josephcabrera-cmyk/birthday-countdown-clock/docs/source/presentation.pptx

## Birthday Countdown Timer

By Joseph Cabrera

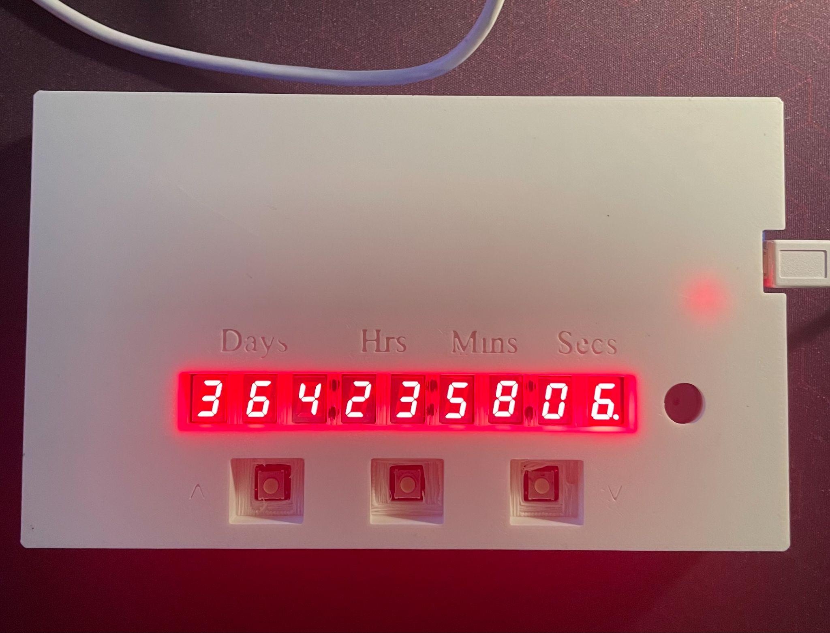
[picture p4: figure]

## Schematic Diagram Pt. 1

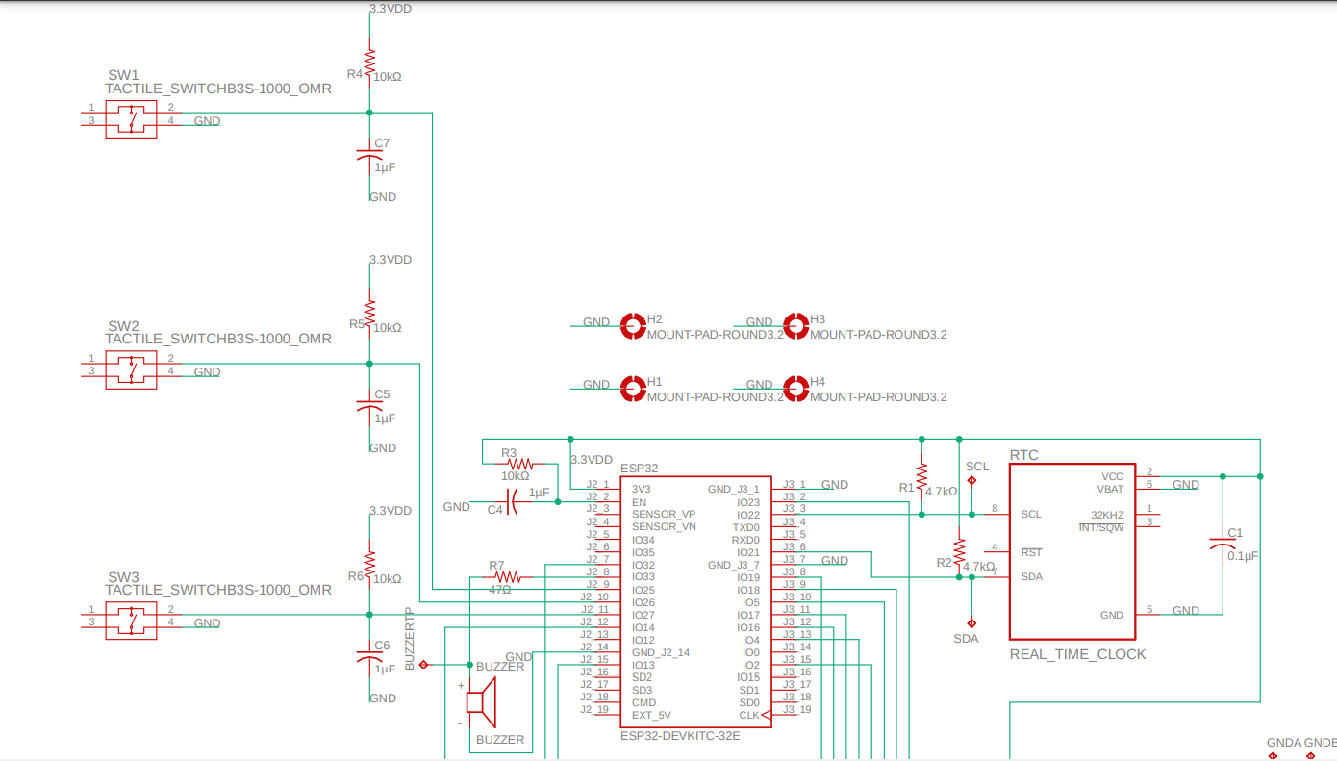
[picture p5: figure]

- ESP32-Devkit

- 3 Pushbuttons

- Buzzer

- Real-Time Clock

- Grounded Mounting Holes

## Schematic Diagram Pt.2

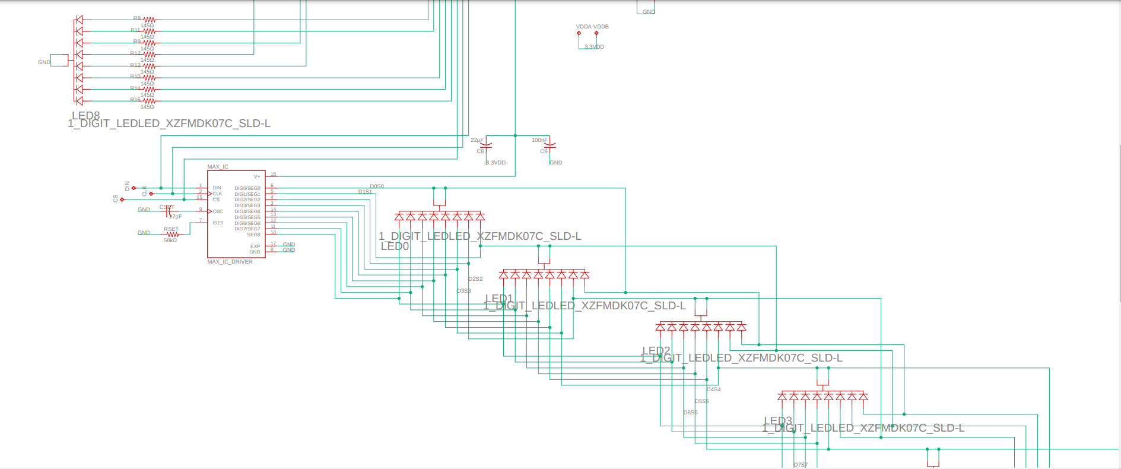
[picture p6: figure]

…

- 7-segment LED connected directly to ESP32-Devkit

- Eight 7-segment LEDs driven by display driver

- Display Driver

## Board Layout

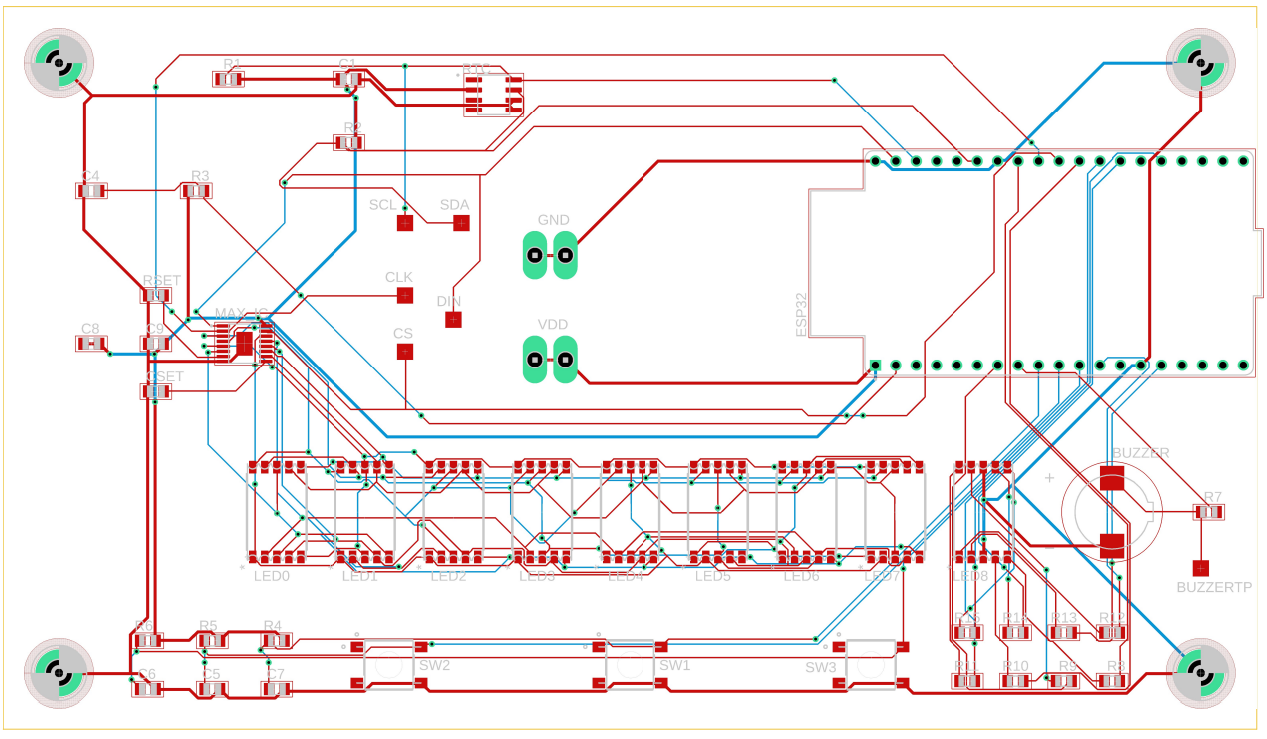
[picture p7: figure]

- ESP32-Devkit

- Real-Time Clock

- Display Driver

- Nine 7-segment LEDs

- Three Pushbuttons

- Buzzer

- Test Points

## Board Photos


## Case Design (Bottom)

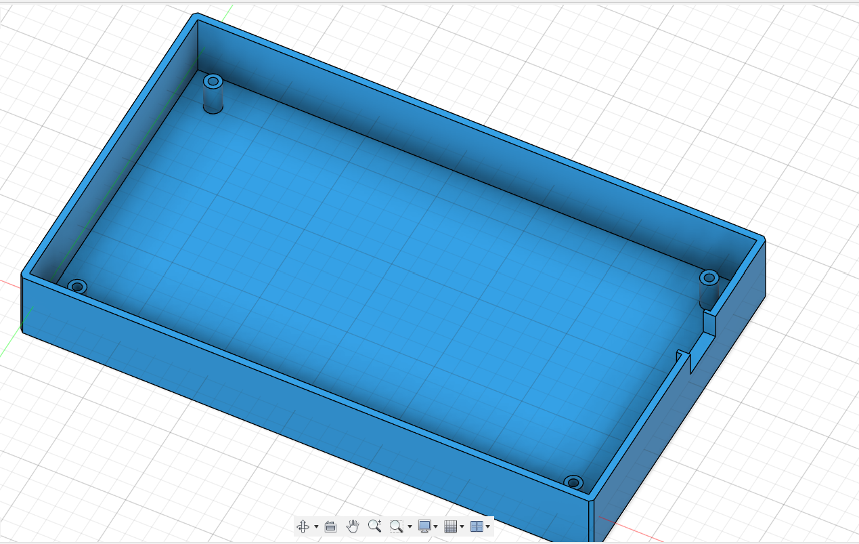
[picture p8: figure]

- Four screw holes diameter of 2.6mm

- Micro USB insert hole

## Case Design (Top)

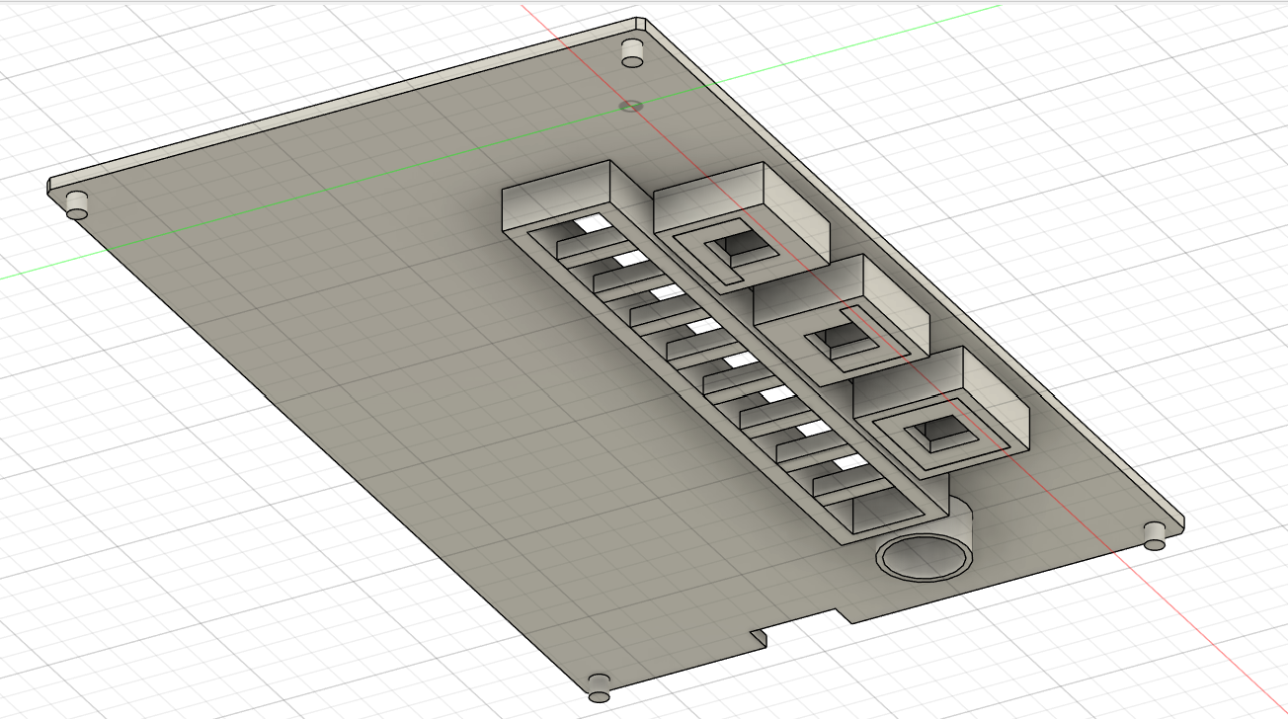
[picture p9: figure]

- Four tangential pins for connecting to the bottom

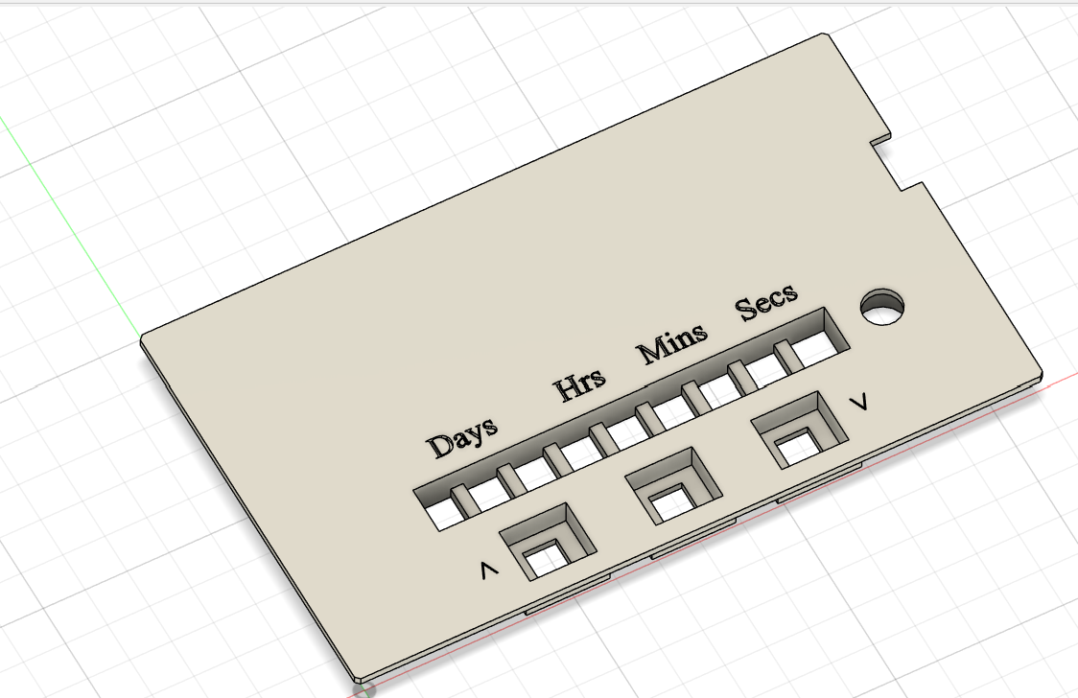
[picture p10: figure]

- Holes for 7-segment LEDs

- Holes for pushbuttons

- Hole for the buzzer

- Some text

- Indent for micro USB

## Results

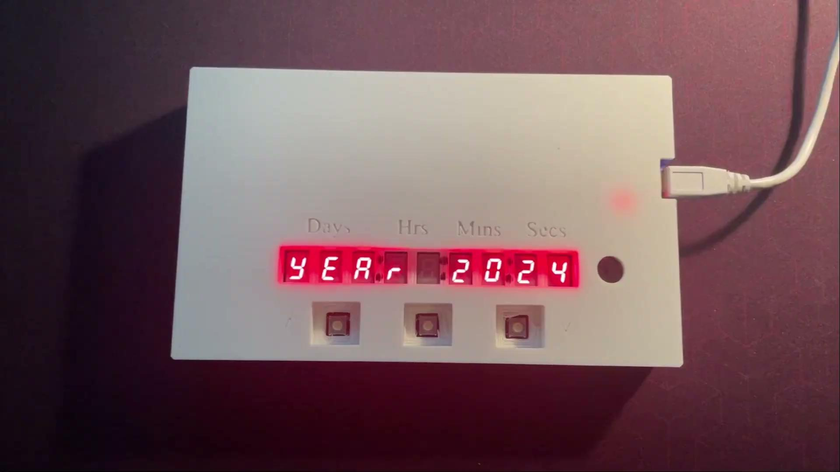
[picture p11: figure]
