josephcabrera-cmyk/birthday-countdown-clock/docs/presentation.pdf

# Birthday Countdown Timer

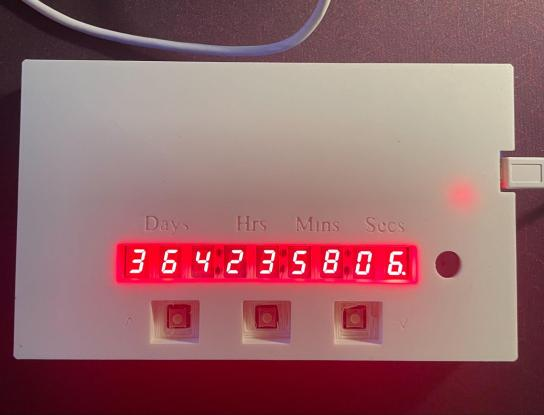
[picture p12: figure]

# By Joseph Cabrera

## Schematic Diagram Pt. 1

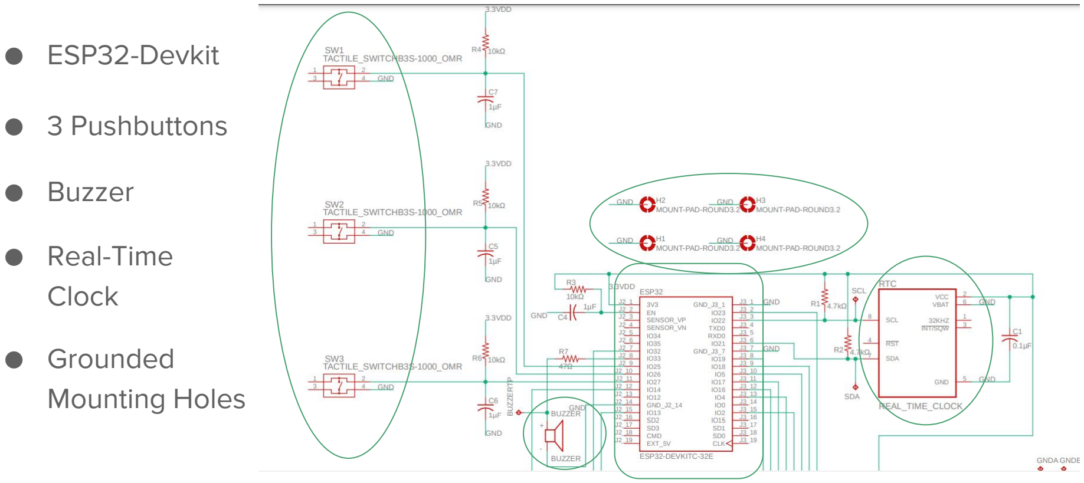
[picture p13: figure]
● ESP32-Devkit; ● 3 Pushbuttons; ● Buzzer; ● Real-Time Clock; ● Grounded Mounting Holes

## Schematic Diagram Pt.2

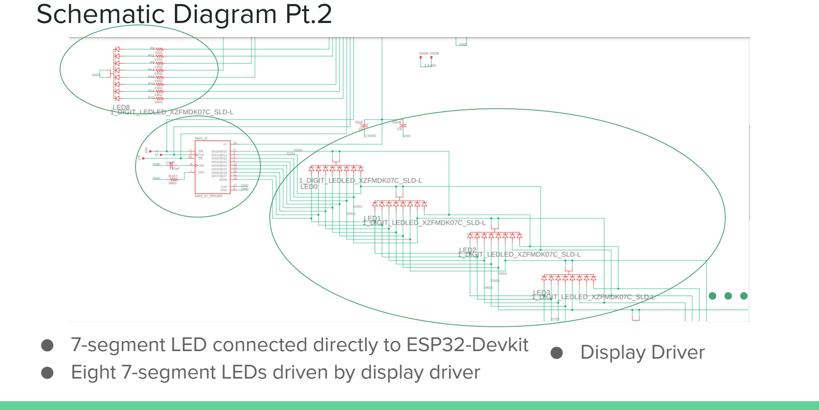
[picture p14: page 3]

- 7-segment LED connected directly to ESP32-Devkit ● Display Driver
- Eight 7-segment LEDs driven by display driver

…

## Board Layout

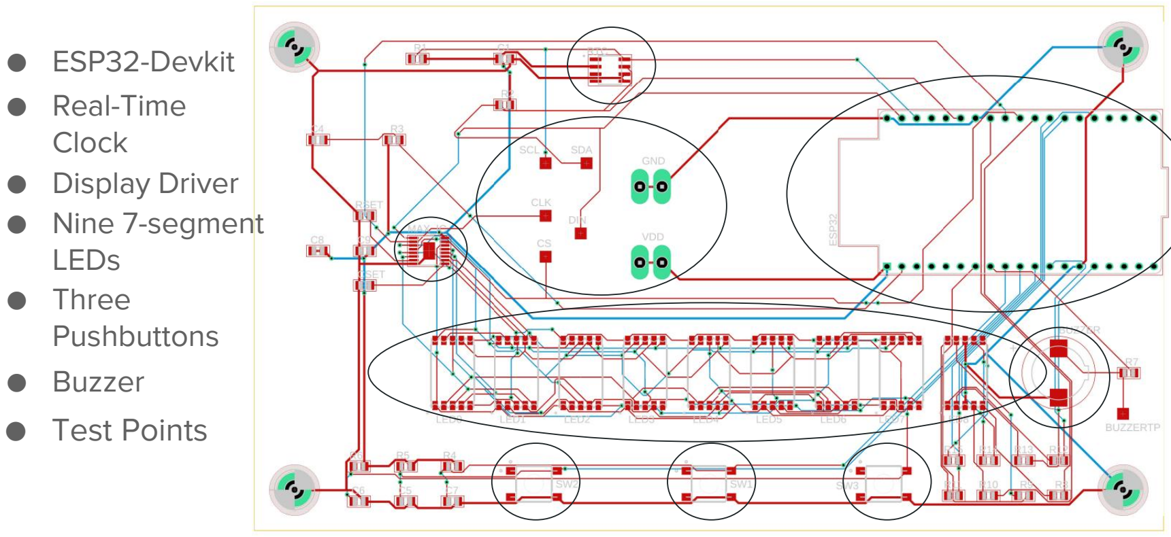
[picture p15: figure]
● ESP32-Devkit ● Real-Time Clock ● Display Driver ● Nine 7-segment LEDs ● Three Pushbuttons ● Buzzer ● Test Points

## Board Photos

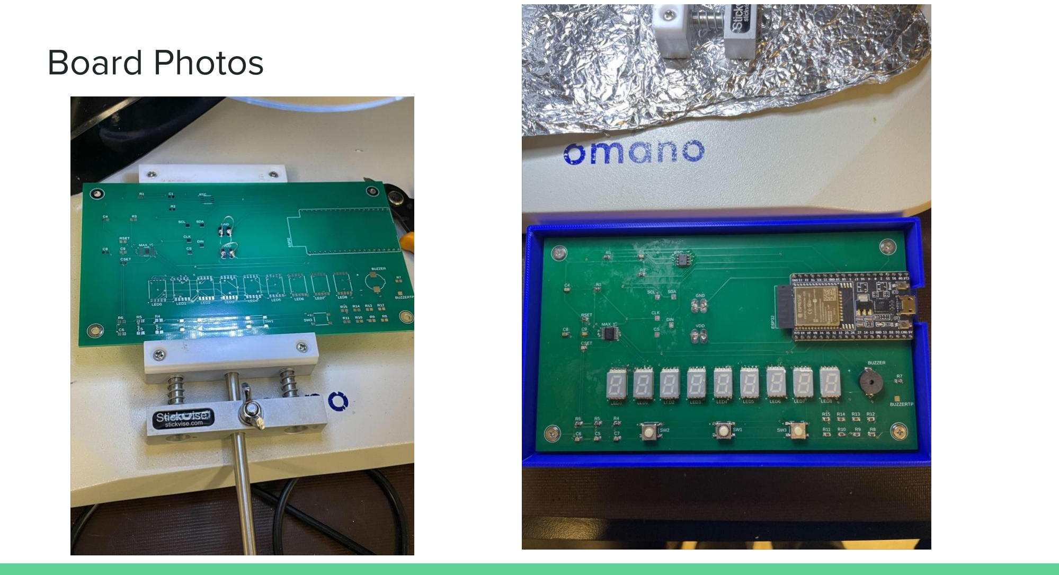
[picture p16: page 5]

## Case Design (Bottom)

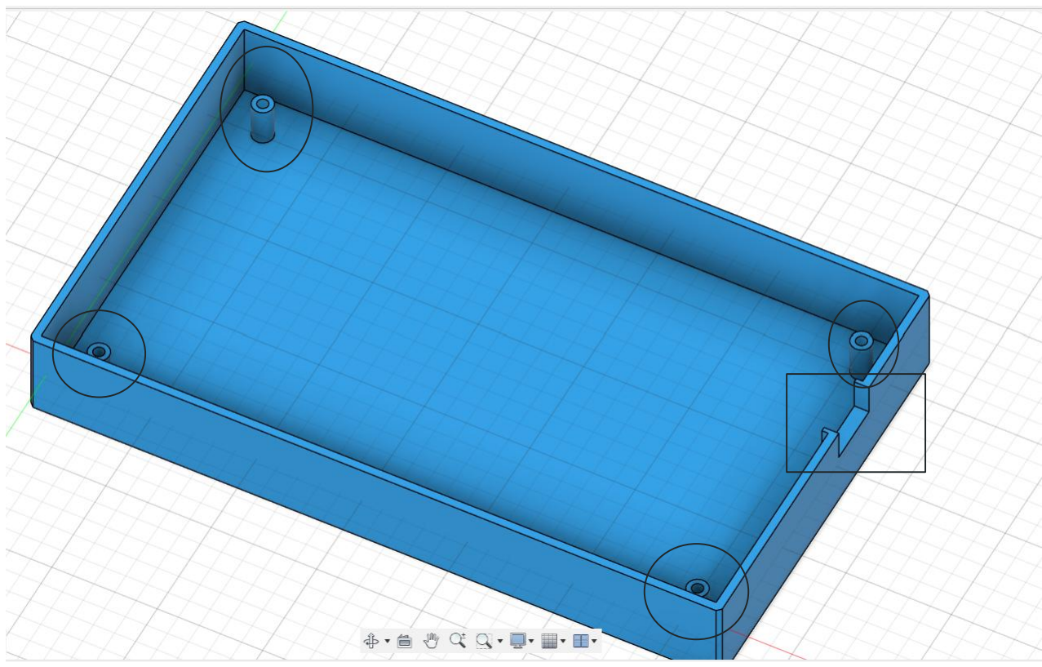
[picture p17: figure]

- Four screw holes
diameter of
2.6mm
- Micro USB
insert hole

## Case Design (Top)

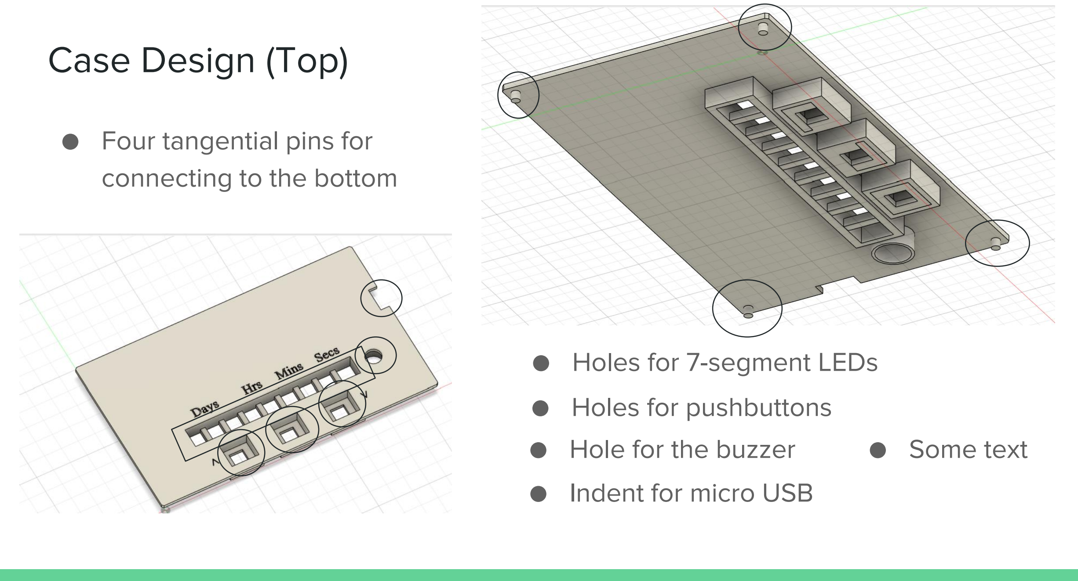
[picture p18: page 7]

- Four tangential pins for connecting to the bottom
- Holes for 7-segment LEDs
- Holes for pushbuttons
- Hole for the buzzer
- Indent for micro USB
- Some text

## Results

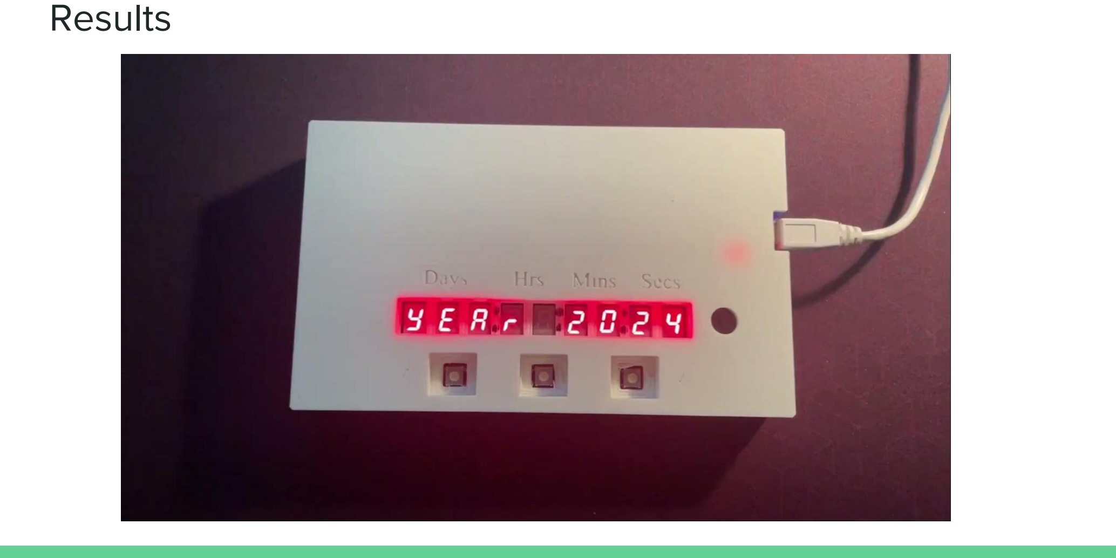
[picture p19: page 8]

Untitled video (1).mp4 (http://drive.google.com/file/d/1gSHd87OxV9lMGyYuL7m6IwtHUoTBj-bI/view)
