josephcabrera-cmyk/birthday-countdown-clock/hardware/board-layout.pdf

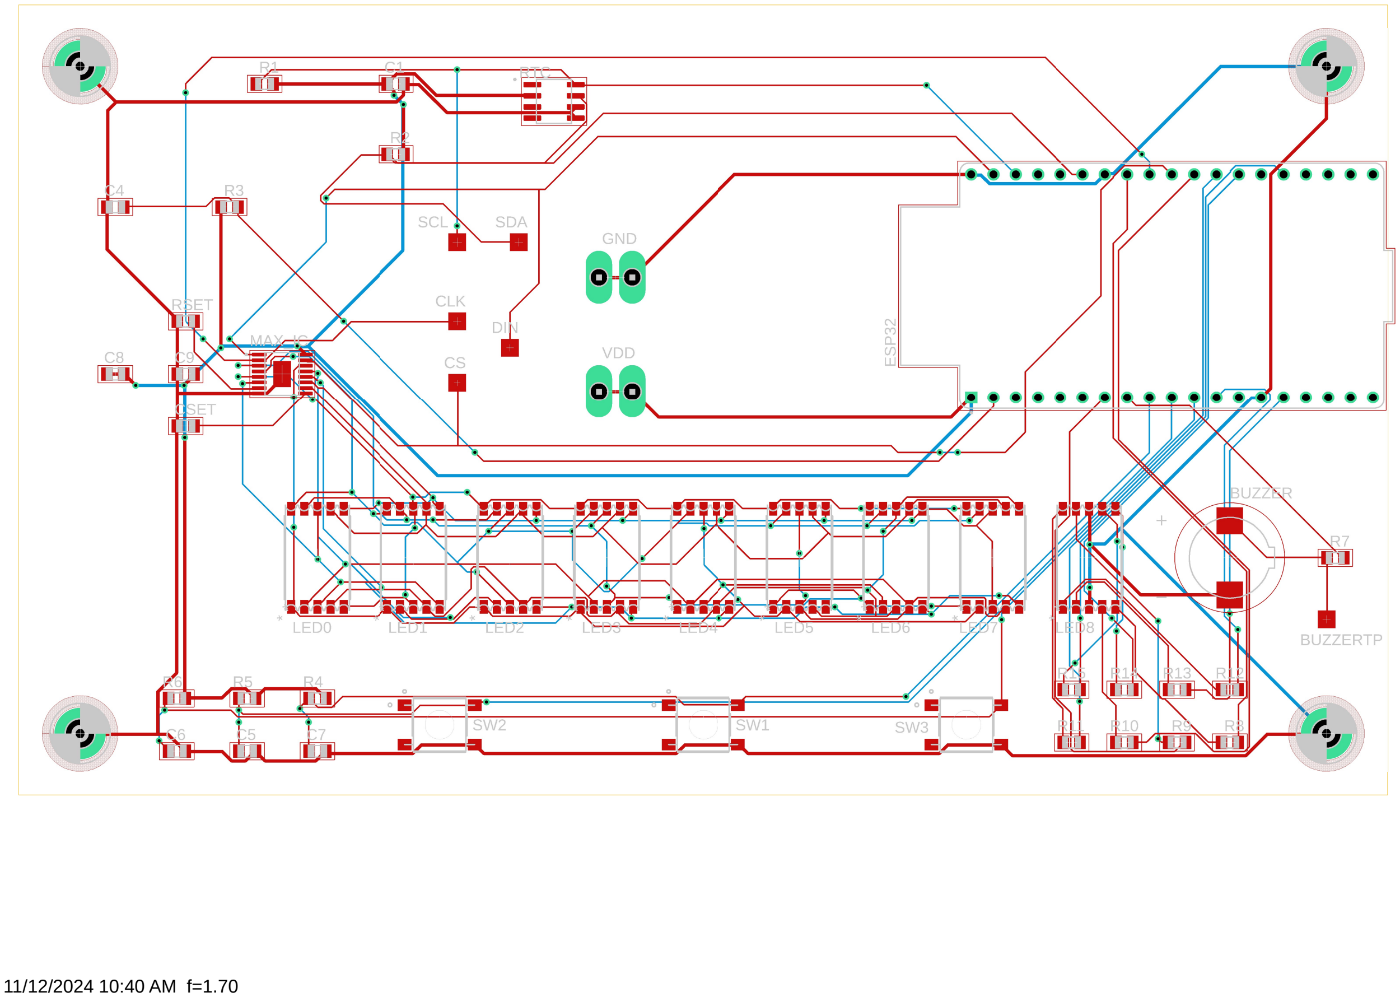
[picture p20: page 1]

11/12/2024 10:40 AM f=1.70
