josephcabrera-cmyk/birthday-countdown-clock/hardware/source/bill-of-materials.xlsx

Reference Designator | Vendor | Vendor part # | Manufacturer | Manufacturer part # | Quantity required
ESP32 | DigiKey | 1965-ESP32-DEVKITC-32E-ND | Espressif Systems | ESP32-DEVKITC-32E | 1
RTC | DigiKey | 175-DS3231MZ+TRLCT-ND | Analog Devices Inc./Maxim Integrated | DS3231MZ+TRL | 1
LED0-8 | DigiKey | 1497-1373-2-ND | SunLED | XZFMDK07C | 9
MAX_IC | DigiKey | MAX6951CEE+-ND | Analog Devices Inc./Maxim Integrated | MAX6951CEE+ | 1
SW1-3 | DigiKey | SW415-ND | Omron Electronics Inc-EMC Div | B3S-1000 | 3
BUZZER | DigiKey | 668-SMTB-0927-TW-RTR-ND | PUI Audio, Inc. | SMTB-0927-TW-R | 1
R1-R2 | DigiKey | 541-4131-2-ND | Vishay Dale | CRCW08054K70FKEAC | 2
R3-R6 | DigiKey | RMCF0805FT10K0TR-ND | Stackpole Electronics Inc | RMCF0805FT10K0 | 4
R7 | DigiKey | RMCF0805JT47R0TR-ND | Stackpole Electronics Inc | RMCF0805JT47R0 | 3
R8-R15 | DigiKey | TNPW0805145RDHEA-ND | Vishay Dale | TNPW0805145RDHEA | 8
RSET | DigiKey | P56KATR-ND | Panasonic Electronic Components | ERJ-6GEYJ563V | 1
C1,C9 | DigiKey | 3372-0805B104K500BDTR-ND | Aillen | 0805B104K500BD | 1
C4-C7 | DigiKey | 3372-0805B105K100CCTR-ND | Aillen | 0805B105K100CC | 4
C8 | DigiKey | 3372-0805W226M100CCTR-ND | NextGen Components | 0805W226M100CC | 1
CSET | DigiKey | 490-5869-2-ND | Murata Electronics | GRM1555C1H270JA01D | 1
- | JLCPCB | - | JLCPCB | - | 1
