josephcabrera-cmyk/birthday-countdown-clock/hardware/board-3d.step

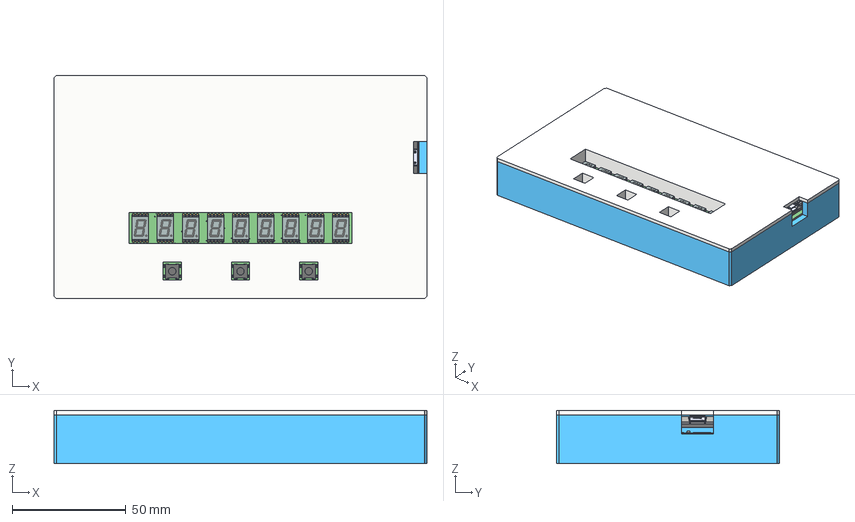
[picture p21: CAD file, 2026-08-03]
hardware/board-3d.step
164.0 x 98.0 x 23.5 mm
Board
1-copper
16-copper
1-soldermask
16-soldermask
C0805 x 8
R0805 x 16
Main-PCB
zl201-19_p2-54_l48-3_w2-54_h8-9 x 2
Soldering-Contacts
ab2_usb_micro_smd.wrl
ESP32-chip
3x4x2mm_tact_button x 2
3,2-PAD (1)
3,2-PAD
3,2-PAD (2)
3,2-PAD (3)
P2-38-20
P2-38-20 (1)
TP20SQ
TP20SQ (1)
TP20SQ (2)
TP20SQ (3)
TP20SQ (4)
TP20SQ (5)
XZFxx07x v1
XZFxx07x v4 (2)
XZFxx07x v4 (3)
XZFxx07x v4 (4)
XZFxx07x v4 (6)
XZFxx07x v4
XZFxx07x v4 (5)
XZFxx07x v4 (1)
LED_XZFMDK07C_SLD-L (1)
B3S-1000_OMR
B3S-1000_OMR (2)
B3S-1000_OMR (1)
SOP63P602X173-17N
SOIC127P600X175-8N
XDCR_SMTB-0927-TW-R
