josephcabrera-cmyk/birthday-countdown-clock/hardware/bill-of-materials.pdf

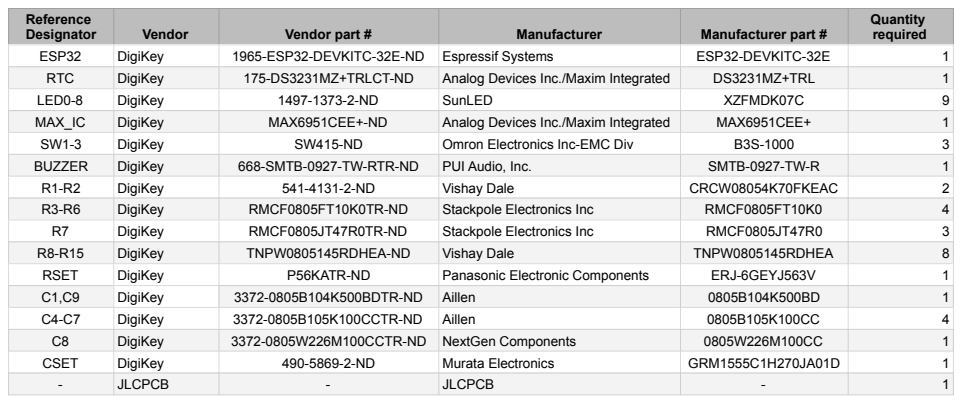
[picture p22: page 1]
Reference; Designator; Vendor; Vendor part #; Manufacturer; Manufacturer part #; Quantity required; ESP32; DigiKey; 1965-ESP32-DEVKITC-32E-ND; Espressif Systems; ESP32-DEVKITC-32E; RTC; 175-DS3231MZ+TRLCT-ND; Analog Devices Inc./Maxim Integrated; DS3231MZ+TRL; LED0-8; SunLED; XZFMDK07C; MAX_IC; MAX6951CEE+-ND; MAX6951CEE+; Omron Electronics Inc-EMC Div; BUZZER; 668-SMTB-0927-TW-RTR-ND; PUI Audio, Inc.; SMTB-0927-TW-R; Vishay Dale; CRCW08054K70FKEAC; RMCF0805FT10K0TR-ND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
