josephcabrera-cmyk/birthday-countdown-clock/hardware/schematic.pdf

# 10kΩ MAX_IC_DRIVER

## TACTILE_SWITCHB3S-1000_OMR

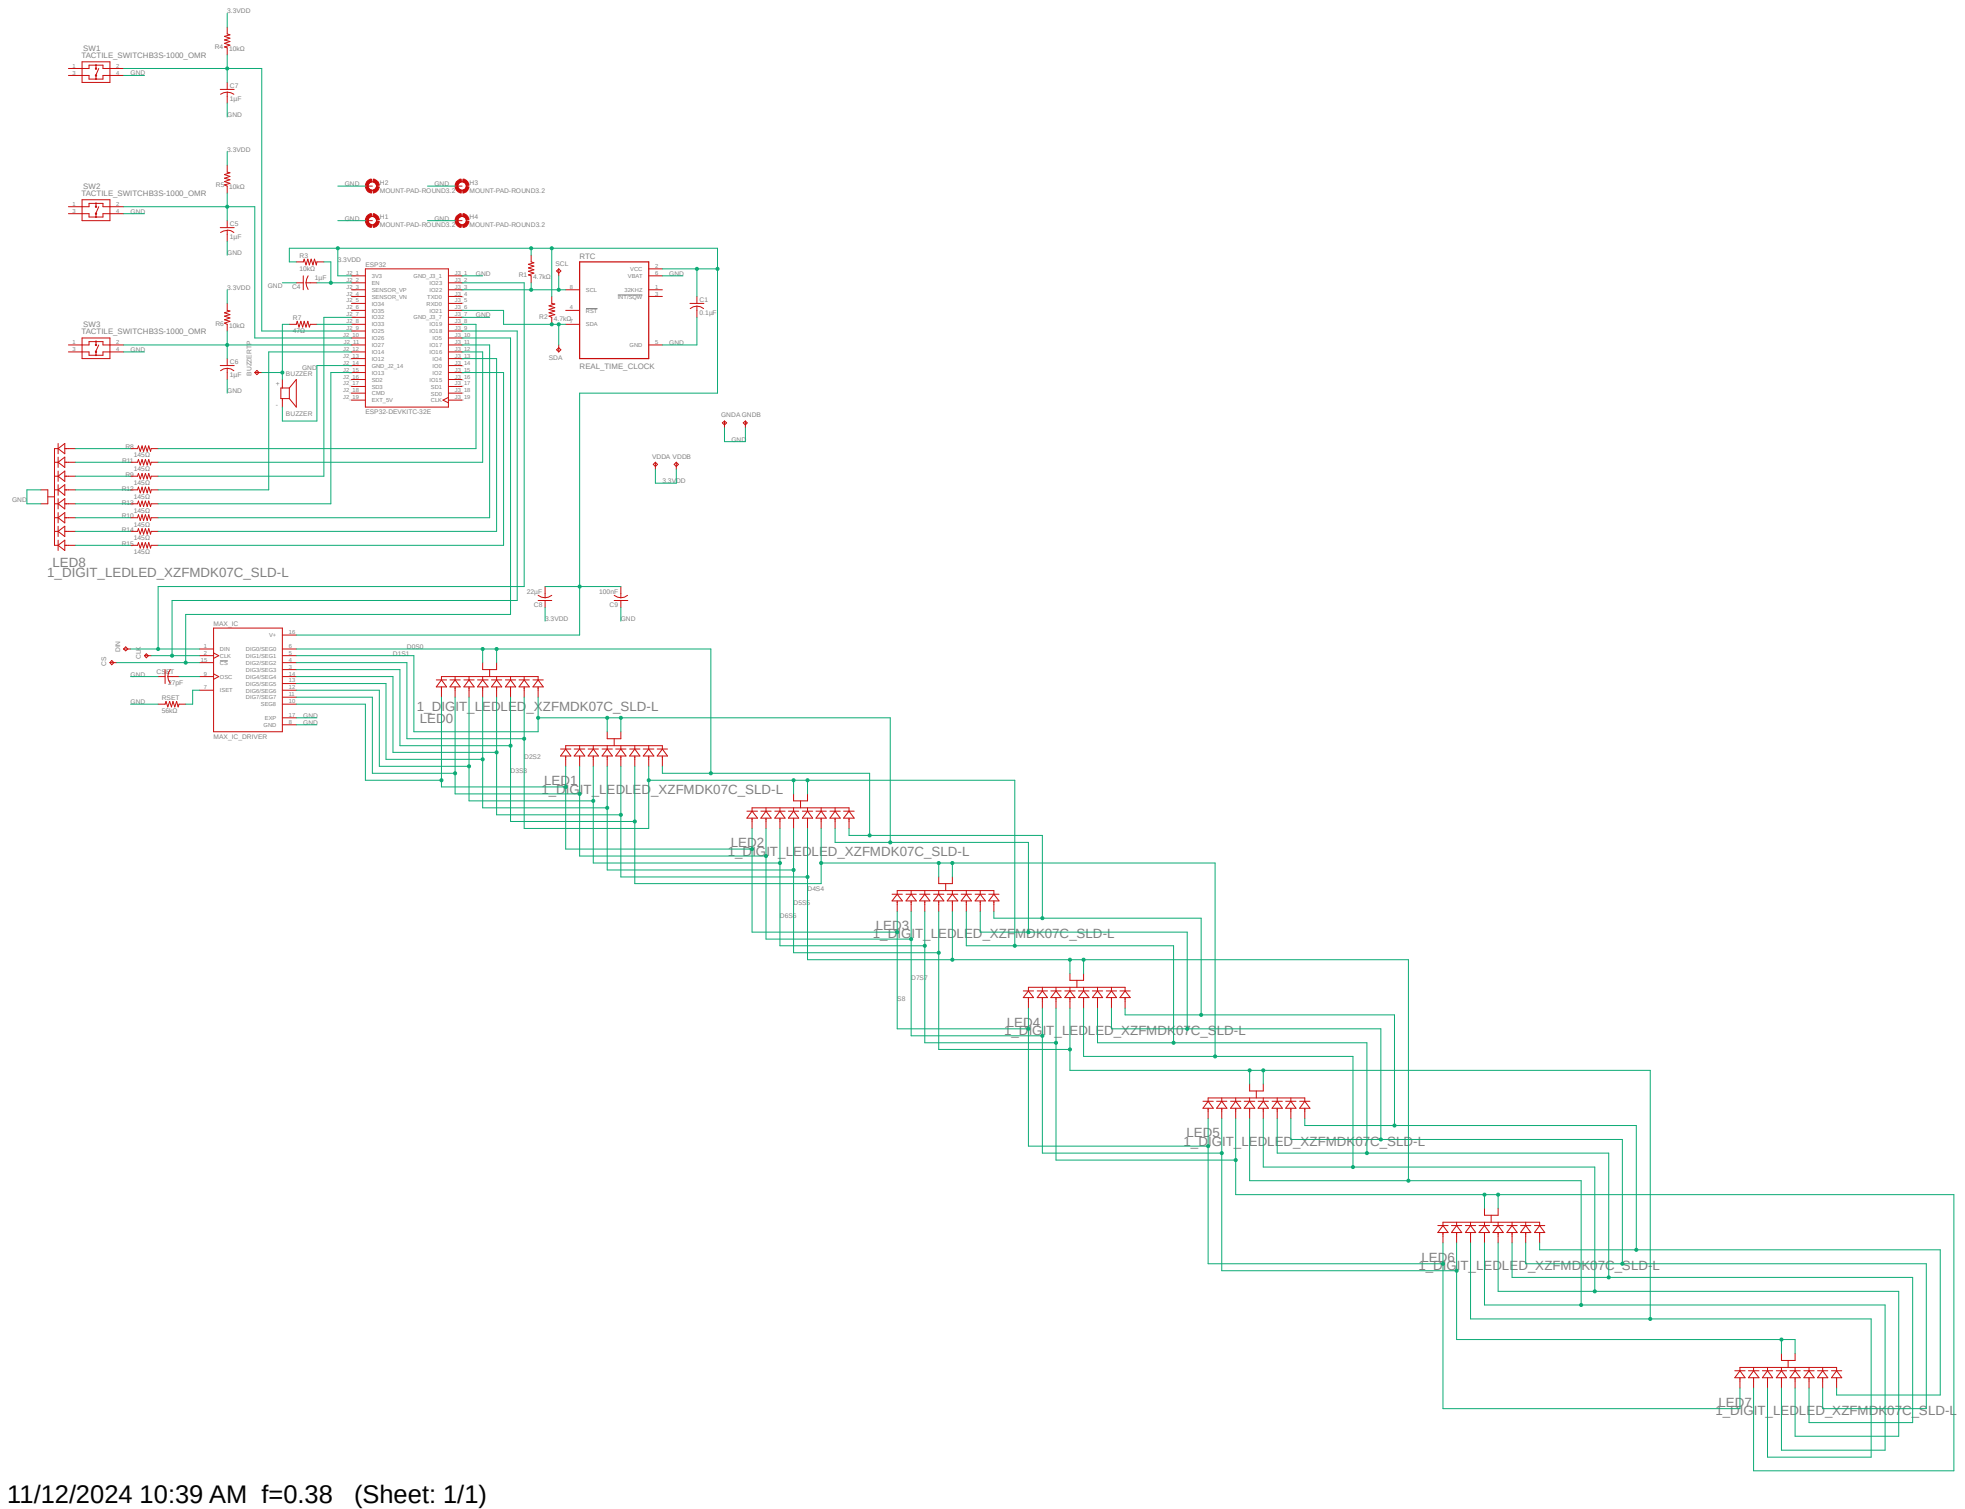
[picture p23: page 1]

VDDA VDDB DIN CS
