josephcabrera-cmyk/birthday-countdown-clock/hardware/source/birthday-countdown-clock.brd

## EAGLE design hardware/source/birthday-countdown-clock.brd (2026-08-03)

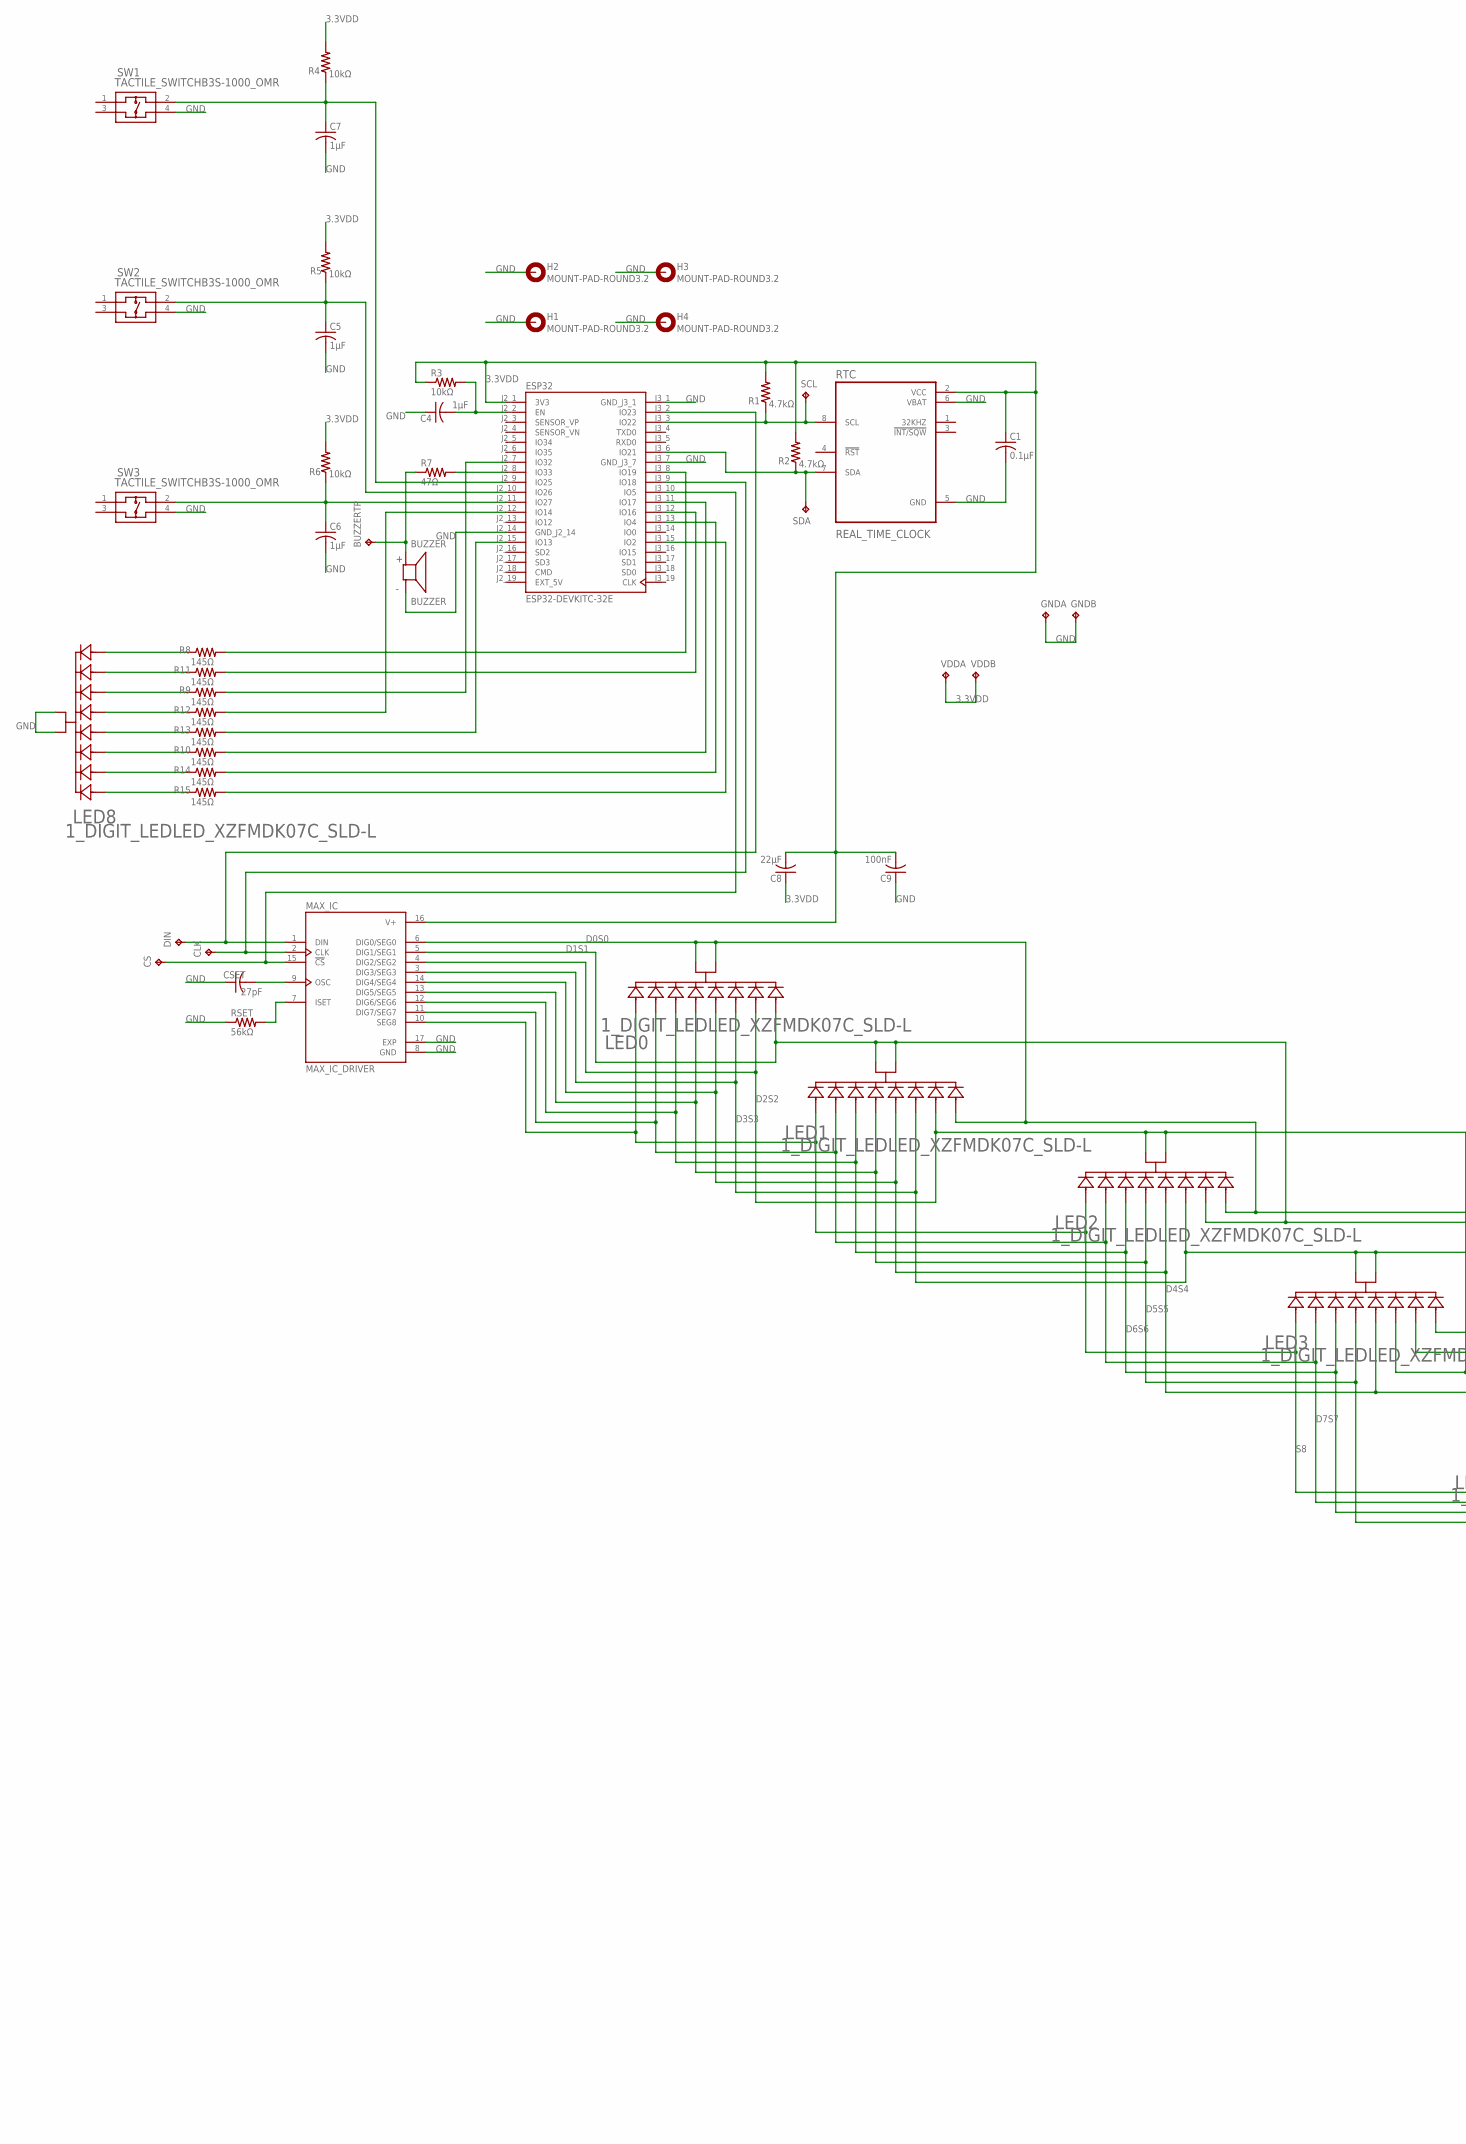
[picture p24: schematic birthday-countdown-clock.sch, part in row 1, column 1]

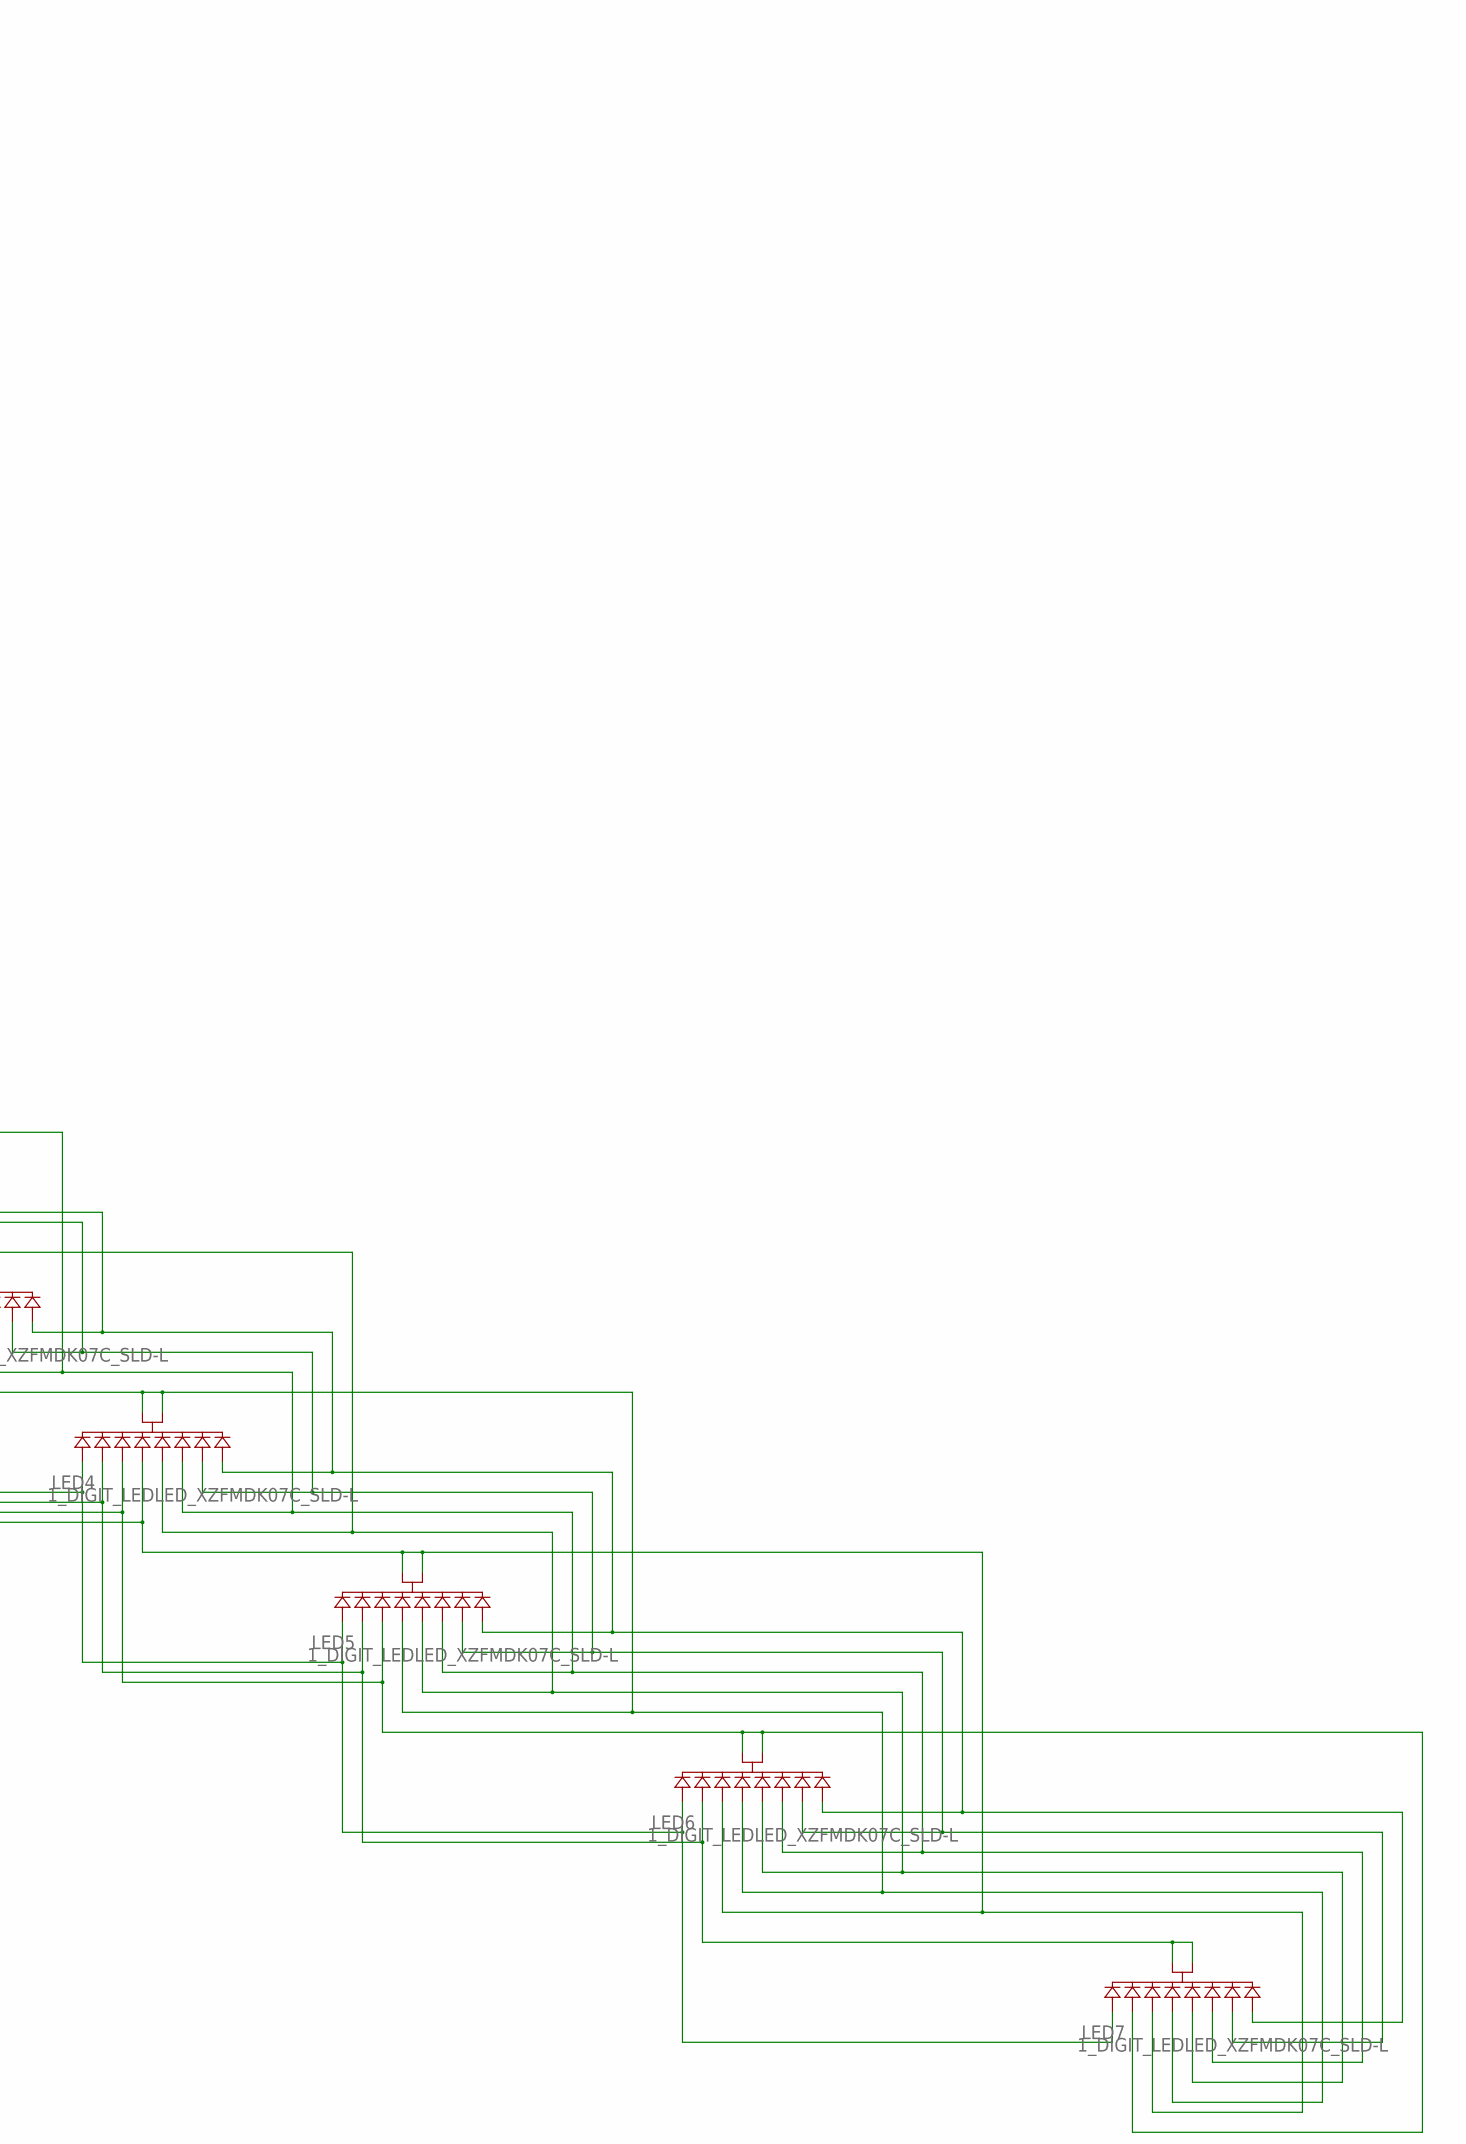
[picture p25: schematic birthday-countdown-clock.sch, part in row 1, column 2]

Parts:
BUZZER: BUZZER; XDCR_SMTB-0927-TW-R
BUZZERTP: TPTP20SQ; TP20SQ
C1: 0.1µF; C0805
C4, C5, C6, C7: 1µF; C0805
C8: 22µF; C0805
C9: 100nF; C0805
CLK: TPTP20SQ; TP20SQ
CS: TPTP20SQ; TP20SQ
CSET: 27pF; C0805
DIN: TPTP20SQ; TP20SQ
ESP32: ESP32-DEVKITC-32E; MODULE_ESP32-DEVKITC-32E
GND: TP2P2-38-20; P2-38-20
H1, H2, H3, H4: MOUNT-PAD-ROUND3.2; 3,2-PAD
LED0, LED1, LED2, LED3, LED4, LED5, LED6, LED7, LED8: 1_DIGIT_LEDLED_XZFMDK07C_SLD-L; LED_XZFMDK07C_SLD-L
MAX_IC: MAX_IC_DRIVER; SOP63P602X173-17N
R1, R2: 4.7kΩ; R0805
R3, R4, R5, R6: 10kΩ; R0805
R7: 47Ω; R0805
R8, R9, R10, R11, R12, R13, R14, R15: 145Ω; R0805
RSET: 56kΩ; R0805
RTC: REAL_TIME_CLOCK; SOIC127P600X175-8N
SCL: TPTP20SQ; TP20SQ
SDA: TPTP20SQ; TP20SQ
SW1, SW2, SW3: TACTILE_SWITCHB3S-1000_OMR; B3S-1000_OMR
VDD: TP2P2-38-20; P2-38-20

Connections:
3.3VDD: C1.1, C8.1, C8.2, C9.2, ESP32.J2_1 (3V3), MAX_IC.16 (V+), R1.2, R2.2, R3.1, R4.2, R5.2, R6.2, RTC.2 (VCC), VDD.TP-1, VDD.TP-2
D0S0: LED0.3, LED0.8, LED1.5, LED2.5, LED3.5, LED4.5, LED5.5, LED6.5, LED7.5, MAX_IC.6 (DIG0/SEG0)
D1S1: LED0.5, LED1.3, LED1.8, LED2.10, LED3.10, LED4.10, LED5.10, LED6.10, LED7.10, MAX_IC.5 (DIG1/SEG1)
D2S2: LED0.10, LED1.10, LED2.3, LED2.8, LED3.9, LED4.9, LED5.9, LED6.9, LED7.9, MAX_IC.4 (DIG2/SEG2)
D3S3: LED0.9, LED1.9, LED2.9, LED3.3, LED3.8, LED4.1, LED5.1, LED6.1, LED7.1, MAX_IC.3 (DIG3/SEG3)
D4S4: LED0.1, LED1.1, LED2.1, LED3.1, LED4.3, LED4.8, LED5.2, LED6.2, LED7.2, MAX_IC.14 (DIG4/SEG4)
D5S5: LED0.2, LED1.2, LED2.2, LED3.2, LED4.2, LED5.3, LED5.8, LED6.4, LED7.4, MAX_IC.13 (DIG5/SEG5)
D6S6: LED0.4, LED1.4, LED2.4, LED3.4, LED4.4, LED5.4, LED6.3, LED6.8, LED7.6, MAX_IC.12 (DIG6/SEG6)
D7S7: LED0.6, LED1.6, LED2.6, LED3.6, LED4.6, LED5.6, LED6.6, LED7.3, LED7.8, MAX_IC.11 (DIG7/SEG7)
EXT_5V: ESP32.J2_19 (EXT_5V)
GND: BUZZER.N (-), C1.2, C4.1, C5.2, C6.2, C7.2, C9.1, CSET.1, ESP32.J2_14 (GND_J2_14), ESP32.J3_1 (GND_J3_1), ESP32.J3_7 (GND_J3_7), GND.TP-1, GND.TP-2, H1.B3,2, H2.B3,2, H3.B3,2, H4.B3,2, LED8.3, LED8.8, MAX_IC.8 (GND), MAX_IC.17 (EXP), RSET.1, RTC.5 (GND), RTC.6 (VBAT), SW1.4, SW2.4, SW3.4
unnamed: ESP32.J3_6 (IO21), R2.1, RTC.7 (SDA), SDA.TP
unnamed: ESP32.J3_3 (IO22), R1.1, RTC.8 (SCL), SCL.TP
unnamed: MAX_IC.7 (ISET), RSET.2
unnamed: CLK.TP, ESP32.J3_9 (IO18), MAX_IC.2 (CLK)
unnamed: CS.TP, ESP32.J3_10 (IO5), MAX_IC.15 (!CS)
unnamed: CSET.2, MAX_IC.9 (OSC)
unnamed: C4.2, ESP32.J2_2 (EN), R3.2
unnamed: LED8.5, R8.1
unnamed: ESP32.J3_15 (IO2), R15.2
unnamed: BUZZER.P (+), BUZZERTP.TP, R7.1
unnamed: DIN.TP, ESP32.J3_2 (IO23), MAX_IC.1 (DIN)
unnamed: ESP32.J2_8 (IO33), R7.2
unnamed: ESP32.J3_13 (IO4), R14.2
unnamed: ESP32.J3_11 (IO17), R10.2
unnamed: ESP32.J2_15 (IO13), R13.2
unnamed: ESP32.J2_12 (IO14), R12.2
unnamed: ESP32.J2_7 (IO32), R9.2
unnamed: ESP32.J3_12 (IO16), R11.2
unnamed: ESP32.J3_8 (IO19), R8.2
unnamed: LED8.10, R11.1
unnamed: LED8.9, R9.1
unnamed: LED8.1, R12.1
unnamed: LED8.2, R13.1
unnamed: LED8.4, R10.1
unnamed: LED8.6, R14.1
unnamed: LED8.7, R15.1
unnamed: C5.1, ESP32.J2_10 (IO26), R5.1, SW2.2
unnamed: C6.1, ESP32.J2_11 (IO27), R6.1, SW3.2
unnamed: C7.1, ESP32.J2_9 (IO25), R4.1, SW1.2
S8: LED0.7, LED1.7, LED2.7, LED3.7, LED4.7, LED5.7, LED6.7, LED7.7, MAX_IC.10 (SEG8)

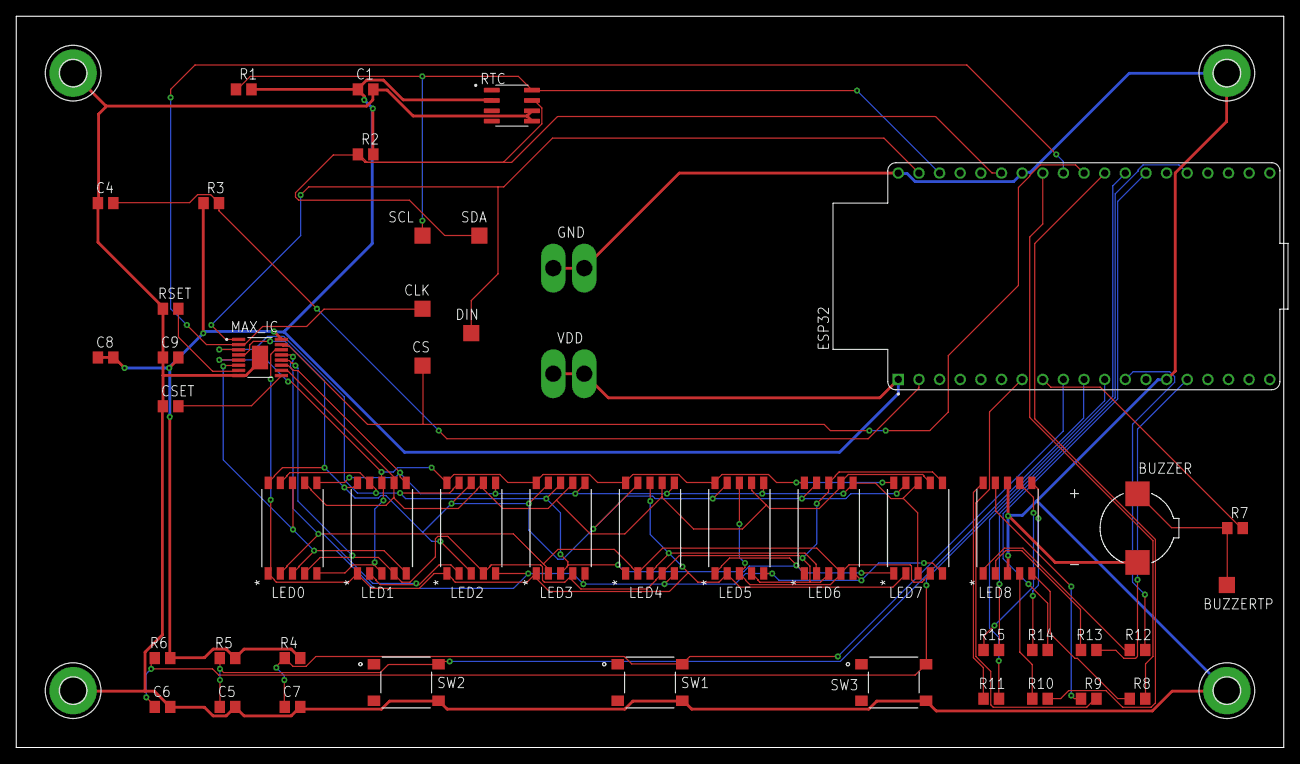
[picture p26: board birthday-countdown-clock.brd from above]

Board: 2 copper layers, 156.0 x 90.0 mm, 52 parts (0 on the bottom side), 40 nets.
