josephcabrera-cmyk/birthday-countdown-clock/(commit log)

2026-07-31 Fill in README TODOs from schematic, BOM, and firmware
    Replace every TODO placeholder with content verified against the
    hardware sources and firmware/main.c, and correct three claims that
    did not match the board as built.
    Corrections:
    - Display part was listed as LDQ-N516RI; the schematic and BOM both
    show SunLED XZFMDK07C.
    - RTC was described as a TCXO at +/-2 ppm. The DS3231M variant on this
    board uses a MEMS resonator and is specified at +/-5 ppm.
    - Claimed the RTC holds time across power loss on a backup cell. No
    coin-cell holder exists in the schematic or BOM, so VBAT is not
    backed and time is lost on every power cycle.
    - MAX6951 decoding described as BCD; the on-chip decoders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
2026-07-31 Tighten Manufacturing section to verifiable claims
    Drop the assertion that the DevKit mounts on removable headers, which
    the layout does not confirm either way, and state the actual package
    mix instead of a vague SOIC/TSSOP/through-hole grouping. The MAX6951
    is a 16-pin QSOP at 0.635 mm pitch, not SOIC.
2026-08-03 Add EAGLE source files and layout findings from the board file
    Add the editable EAGLE 9.7 schematic and board sources, which were
    referenced by the README but had never been committed. Add a
    .gitattributes so the CAD XML round-trips byte-exact instead of being
    line-ending converted on checkout.
    Reading the board file directly confirmed several things the rendered
    PDFs could not, and the README is updated accordingly:
    - VBAT is tied directly to GND. This is stronger and more accurate than
    the previous "no coin-cell holder in the BOM" phrasing: it is the
    datasheet's specified configuration for running without a backup
    supply, so it is deliberate rather than an omission.
    - The RTC leave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
    [board-layout.brd, schematic.sch]
2026-08-03 Add 3D model and correct the USB connector type
    Add hardware/board-3d.step, an AP214 export of the assembled board as
    solid geometry, so an enclosure can be modelled against real dimensions.
    Mark STEP as non-diffable in .gitattributes; a textual diff of a 19 MB
    3D export is never useful.
    Also correct the USB connector. The README described the input as
    USB-A, but the custom board carries no connector of its own and the
    ESP32-DevKitC-32E uses Micro-USB, so both the spec table and the
    improvement item were wrong. Split the old combined USB/enclosure
    improvement into two, since they are unrelated changes.
    [board-3d.step]
2026-08-03 License hardware under CERN-OHL-P-2.0 alongside MIT firmware
    The repository is mostly hardware -- schematic, board file, BOM and 3D
    model -- and MIT does not map cleanly onto design files, since its terms
    are written around "the Software".
    Add hardware/LICENSE carrying the CERN Open Hardware Licence v2
    (Permissive), the hardware-world equivalent at the same permissive
    level, so both halves of the project keep the same practical terms.
    The licence body is the canonical SPDX text, unmodified.
    The root LICENSE stays pure MIT and now scopes to firmware/.
2026-08-03 Extend copyright range to 2024-2026
    The board was designed in 2024; the documentation, licensing and
    published sources date from 2026.
2026-08-04 Add ESE 323 course documents, board photos, and corrections from them
    Add the original December 2024 course submissions -- the final paper and
    the presentation -- the editable BOM spreadsheet that the committed
    bill-of-materials.pdf was generated from, and the two board photographs
    extracted from the presentation.
    The assembled-board photo goes near the top of the README, which until
    now opened on a demo GIF alone. The mid-assembly shot sits in the
    Manufacturing section, where its legible silkscreen shows the labelled
    test points and the R8-R15 ballast cluster beside LED8 that the text
    describes.
    The paper is as submitted except for its closing section of feedback
    addressed to the course i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
    [bill-of-materials.xlsx]
2026-08-04 Surface the course and date at the top of the README
    The term appeared once, mid-paragraph, below the fold. State it in the
    header line under the title and add Course and Term rows to the spec
    table, so anyone landing on the repository sees when the work was done
    without reading for it.
    Dates are from the primary sources: the EAGLE files are dated 12
    November 2024 and the course paper 8 December 2024.
2026-10-21 Correct DS3231M and ESP32 datasheet figures in README
    - DS3231M accuracy: ±5 ppm (±0.432 s/day) applies from -45 °C to +85 °C,
    not 0 °C to +40 °C (DS3231M datasheet, p. 2)
    - Improvement 7: the DS3231M has no RS2:RS1 bits and its INT/SQW square
    wave is fixed at 1 Hz, so only INTCN needs clearing (pp. 7, 13)
    - Improvement 8: the ESP32's 40 mA is a typical IOH at VOH >= 2.64 V,
    not an absolute-maximum rating (ESP32-WROOM-32E datasheet, Table 15)
2026-10-22 Rename EAGLE sources to a matching pair
    EAGLE links a schematic and board only when they share a file name, so
    schematic.sch and board-layout.brd opened as two unrelated designs.
    [birthday-countdown-clock.brd, birthday-countdown-clock.sch]
