josephcabrera-cmyk/birthday-countdown-clock/(notices)

Notices in the files:
parts and their libraries:
Birthday Countdown Library: COPYRIGHT: Copyright (C) 2024 Ultra Librarian. All rights reserved.
